g-wimmer/ModulatedInfraredSpeedLogger/Documentation.odt

Modulated Infrared Speed Logger (M.I.S.L)

By Gabriel Wimmer

# Context

The speed of a buggy is arguably one of the most important factors in determining the winner of a buggy race. Having an accurate measure of speed would also be useful in determining how well each pusher performs. Being able to measure the differences in different buggy engineering choices by seeing how much they impact a buggy’s top speed can also allow for data driven design decisions.

Other teams have tackled this challenge through the use of GPS beacons to track location and speed at the same time. However, if you have used a map on your phone, you likely know that they aren’t perfectly accurate and can jump around, leading to inaccurate speed values. This project aims to tackle this problem by providing an accurate measure of speed by timing the rotations of a buggy’s wheels.
