g-wimmer/ModulatedInfraredSpeedLogger/Images/emittertube.jpg

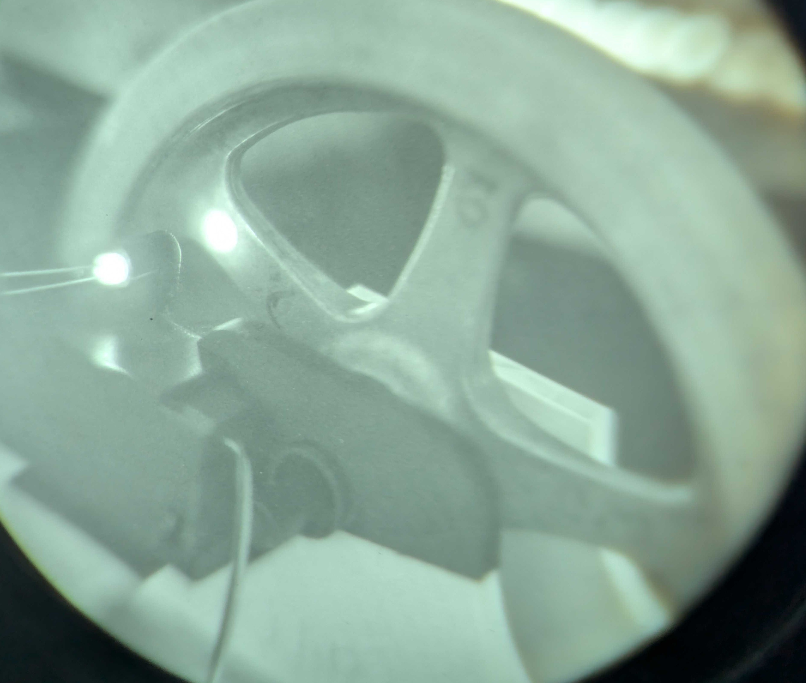
Images/emittertube.jpg
