g-wimmer/ModulatedInfraredSpeedLogger/Images/MISL.png

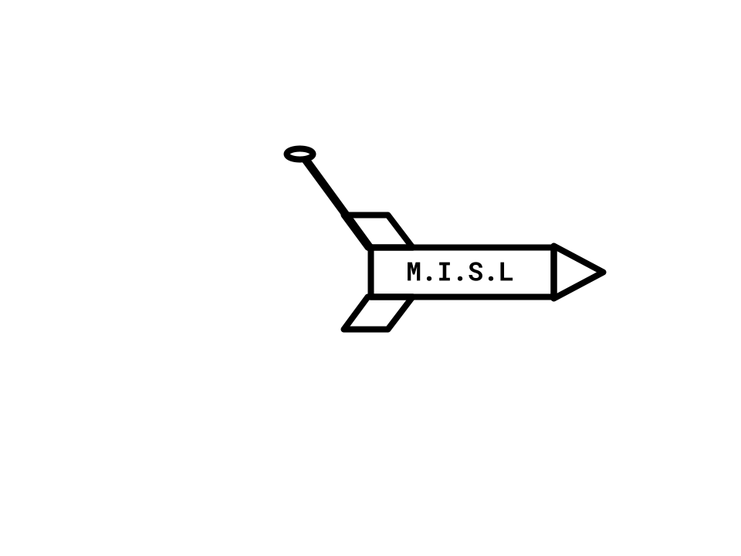
Images/MISL.png
