g-wimmer/ModulatedInfraredSpeedLogger/Images/MISLinBaltic2.jpg

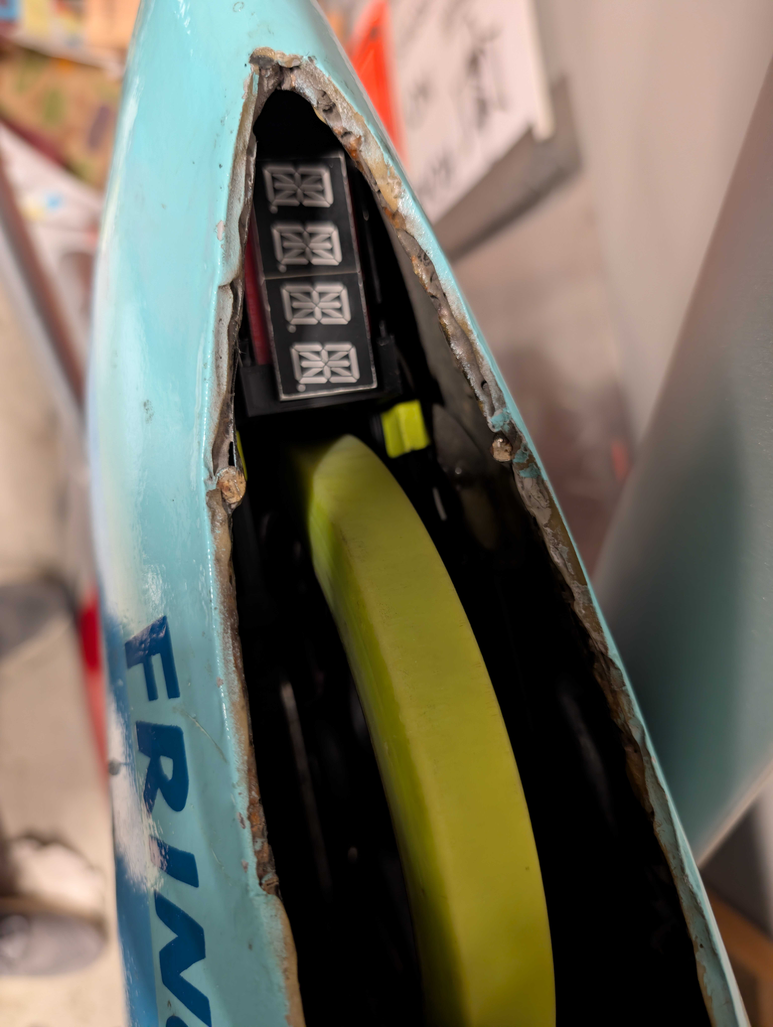
Images/MISLinBaltic2.jpg
