g-wimmer/ModulatedInfraredSpeedLogger/Images/noemittertube.jpg

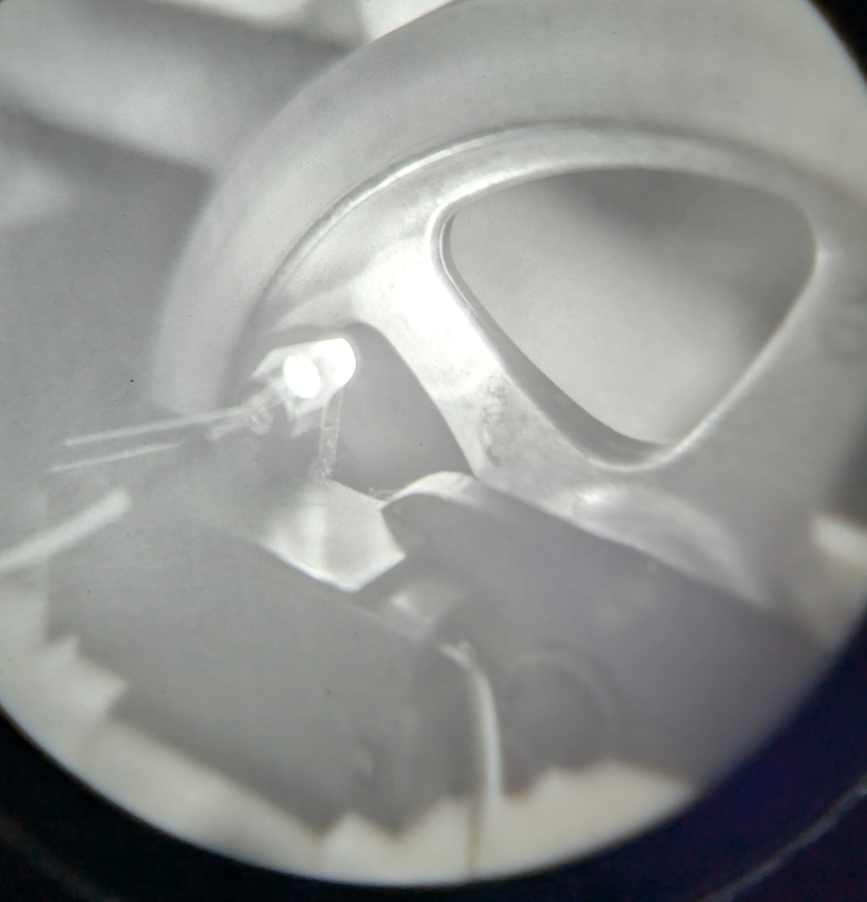
Images/noemittertube.jpg
