g-wimmer/ModulatedInfraredSpeedLogger/Images/rearwheelframe (2).jpg

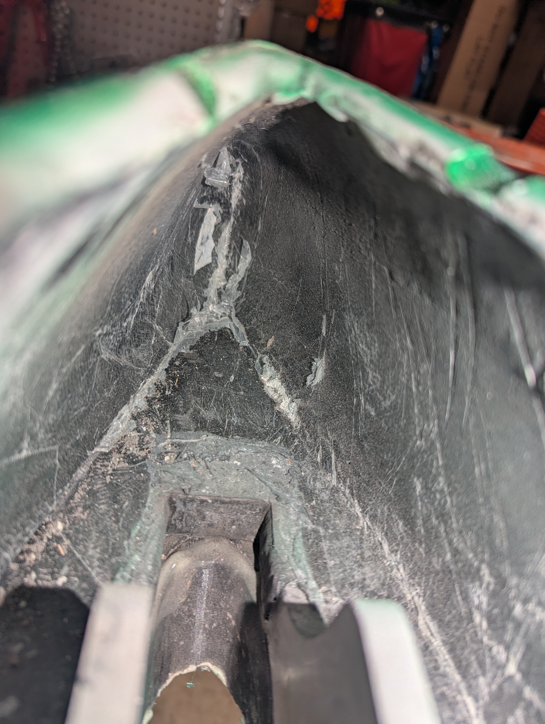
Images/rearwheelframe (2).jpg
