g-wimmer/ModulatedInfraredSpeedLogger/Images/rearwheelframe.jpg

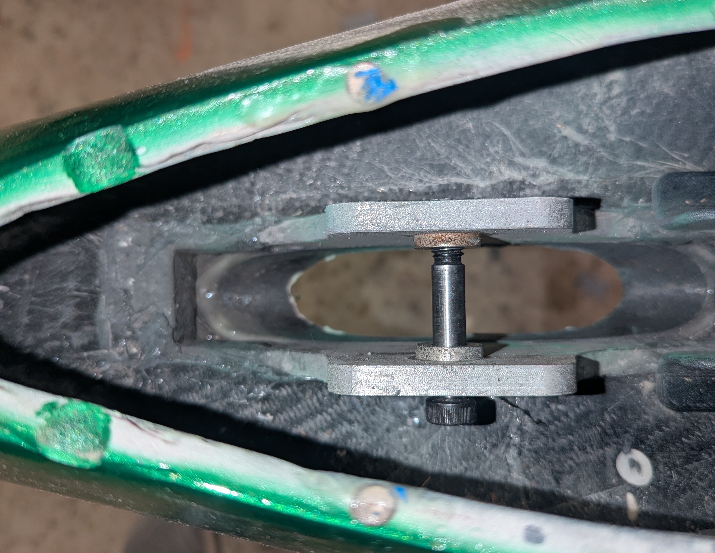
Images/rearwheelframe.jpg
