g-wimmer/ModulatedInfraredSpeedLogger/CAD/SD Card clip.stl

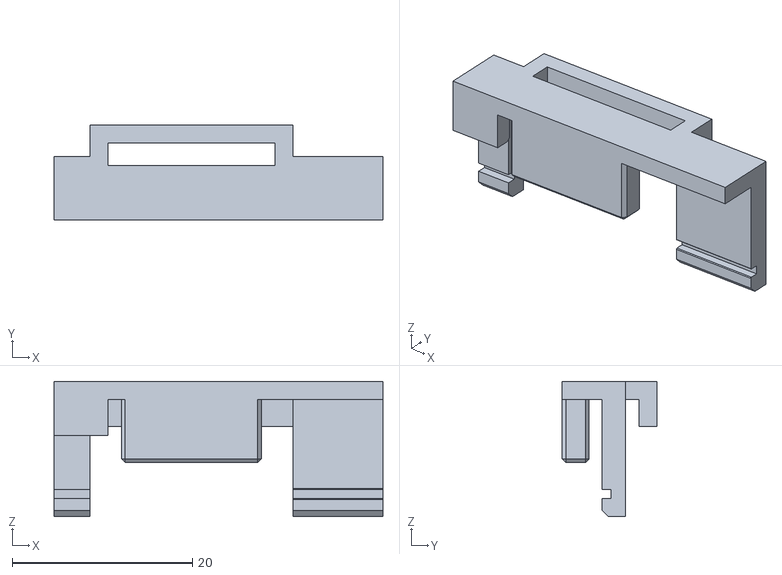
[picture p15: CAD file, 2026-10-28]
CAD/SD Card clip.stl
36.5 x 10.5 x 15.0
