g-wimmer/ModulatedInfraredSpeedLogger/Images/drawing.dxf

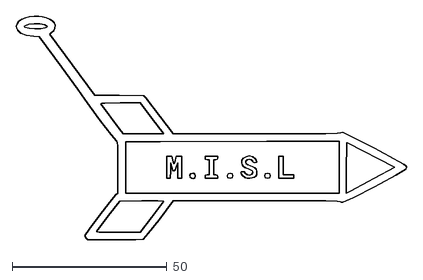
[picture p16: CAD file, 2026-09-28]
Images/drawing.dxf
126.2 x 72.3
