g-wimmer/ModulatedInfraredSpeedLogger/CAD/MISLCaseV2.stl

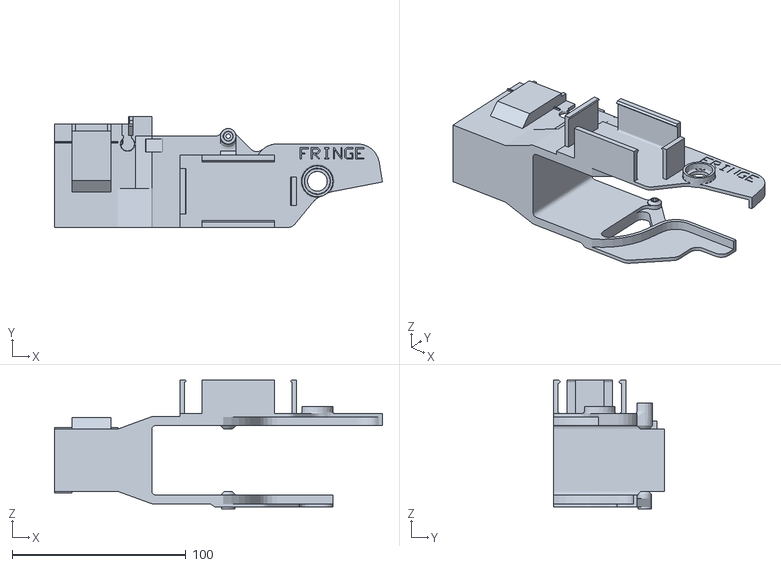
[picture p17: CAD file, 2026-10-23]
CAD/MISLCaseV2.stl
188.7 x 63.8 x 74.0
