g-wimmer/ModulatedInfraredSpeedLogger/CAD/r8bearingplaceholder.stl

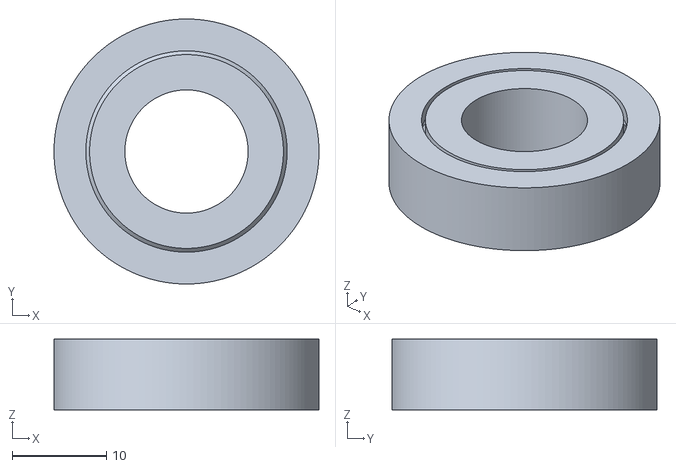
[picture p18: CAD file, 2026-09-27]
CAD/r8bearingplaceholder.stl
28.2 x 28.2 x 7.54
