g-wimmer/ModulatedInfraredSpeedLogger/CAD/MISLcase.stl

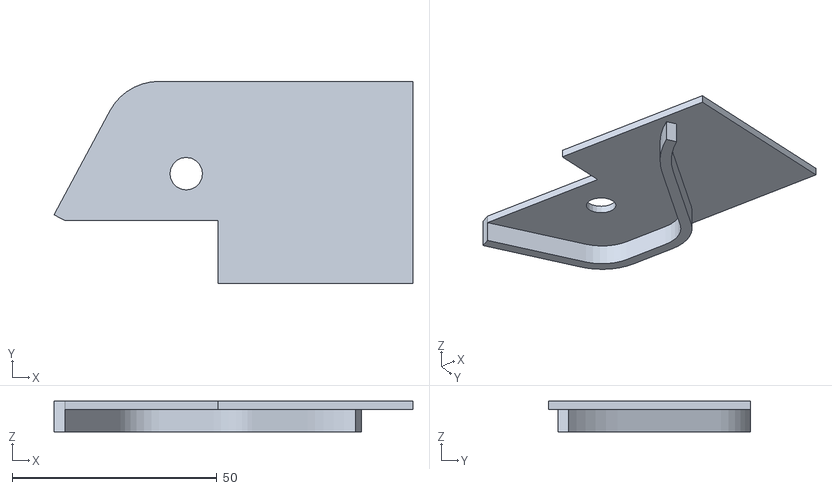
[picture p19: CAD file, 2026-09-27, an earlier design]
CAD/MISLcase.stl
87.7 x 49.4 x 7.50
