g-wimmer/ModulatedInfraredSpeedLogger/(list of files, cad)

Other CAD files:
CAD/MISLCaseV2.ipt
CAD/MISLcase.ipt
