g-wimmer/ModulatedInfraredSpeedLogger/(commit log)

2026-09-27 Started prototyping the case design
    [MISLCaseV2.ipt, MISLcase.ipt, MISLcase.stl, R8bearingplaceholder.scad, r8bearingplaceholder.stl]
2026-09-28 case designing
    [MISLCaseV2.ipt, MISLCaseV2.stl, drawing.dxf]
2026-09-30 added phototransistor holder
    [MISLCaseV2.ipt, MISLCaseV2.stl]
2026-10-19 added some pictures and have a final case prototype.
2026-10-20 small adjustment to case for display fit
2026-10-23 more case changes
2026-10-26 Resized analog circuit image
2026-10-28 Clean cad
2026-10-31 added the current firmware and updated readme
