g-wimmer/ModulatedInfraredSpeedLogger/Images/MISLCore1.jpg

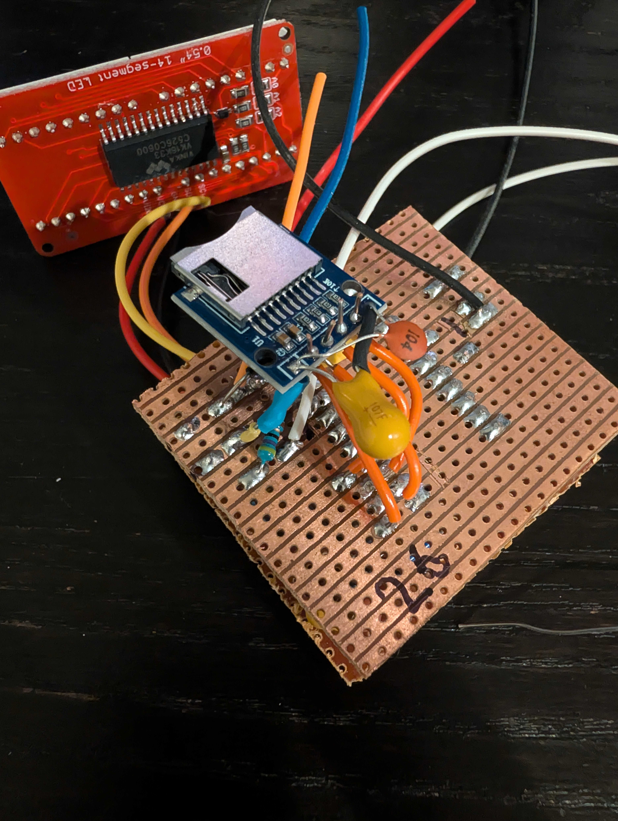
Images/MISLCore1.jpg
