g-wimmer/ModulatedInfraredSpeedLogger/Images/MISLCore2.jpg

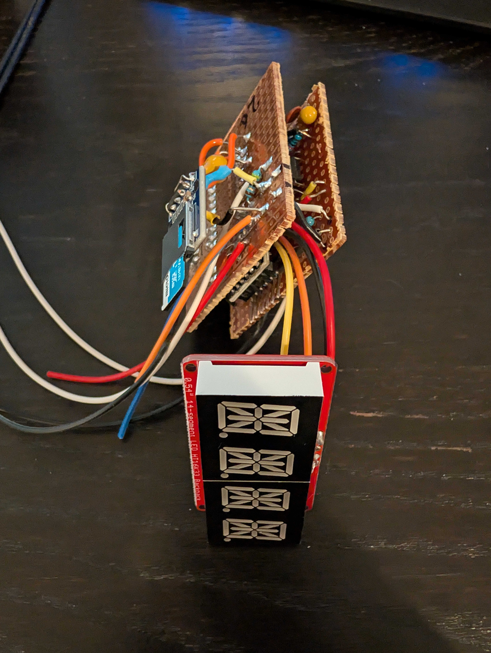
Images/MISLCore2.jpg
