g-wimmer/ModulatedInfraredSpeedLogger/Images/MISLwithSD.jpg

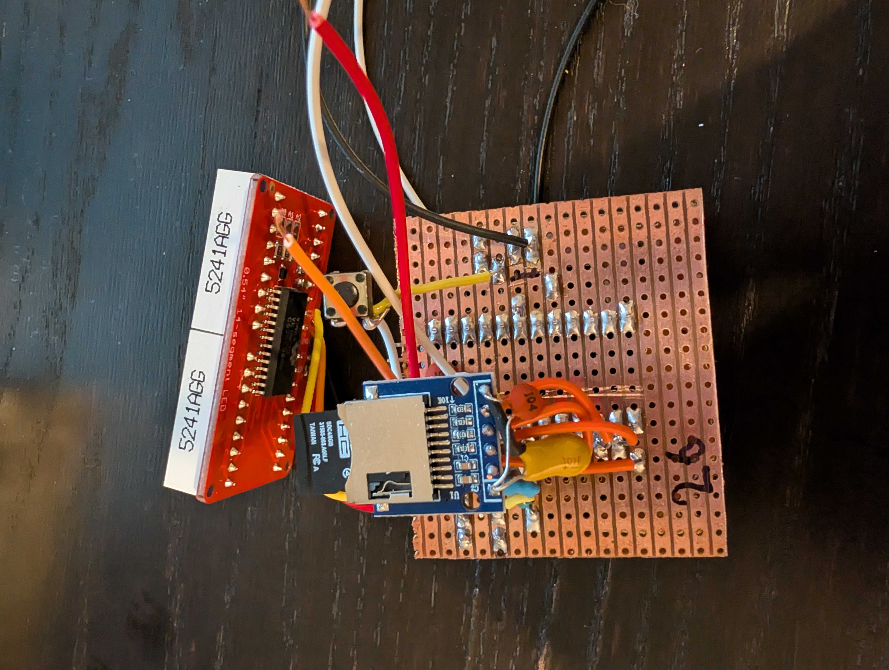
Images/MISLwithSD.jpg
