g-wimmer/ModulatedInfraredSpeedLogger/Images/MISL.jpg

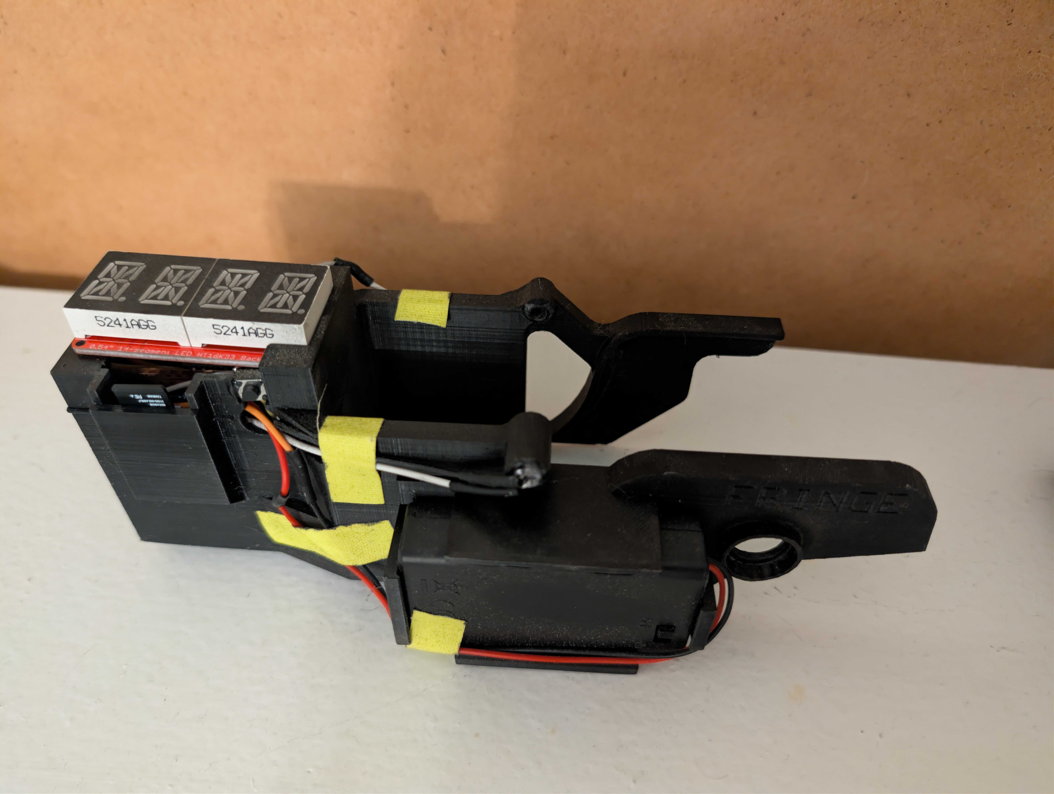
[picture p1: Images/MISL.jpg]
Images/MISL.jpg
