g-wimmer/ModulatedInfraredSpeedLogger/Images/MISLinternals.jpg

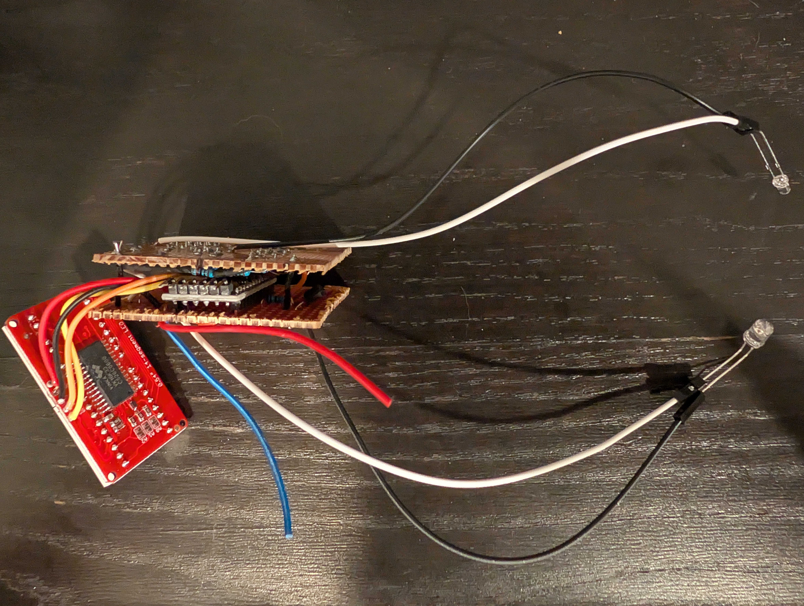
[picture p4: Images/MISLinternals.jpg]
Images/MISLinternals.jpg
